FBSeletronica/Projeto-Natal-2023-Fabio/Projeto Base/Projeto-Natal-2023-Base/Documentação/christimas-ball-front.png

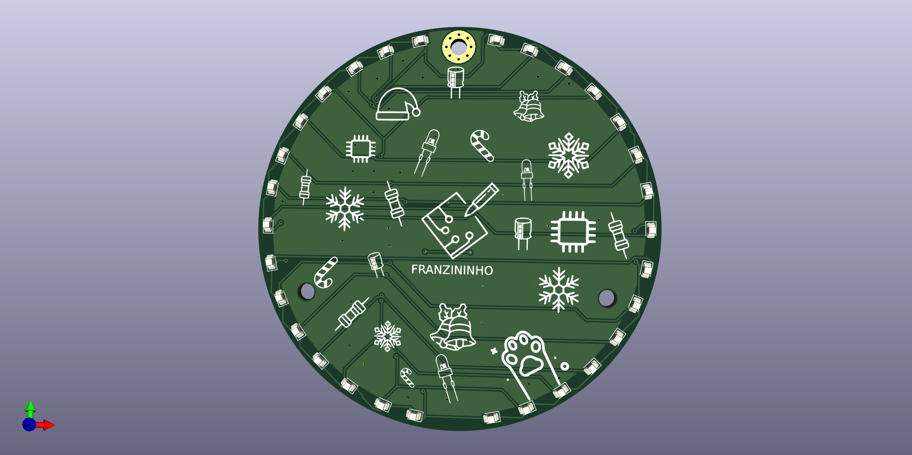
Projeto Base/Projeto-Natal-2023-Base/Documentação/christimas-ball-front.png
