FBSeletronica/Projeto-Natal-2023-Fabio/Projeto Base/Projeto-Natal-2023-Base/Documentação/custos.ods

descrição | valor
placa JLCPCB | 361,2
10 conector bateria | 50,61
5 buzzer | 60,81
10 bolas de acrĺico | 12
Demais componentes | 141,74
impostos placas | 111,33
impostos placas | 86,66
impostos componentes | 78,48
Total | 902,83
Valor por placa | 60,1886666666667
