FBSeletronica/Projeto-Natal-2023-Fabio/Projeto Base/Projeto-Natal-2023-Base/3D/EVQP7A01P.stp

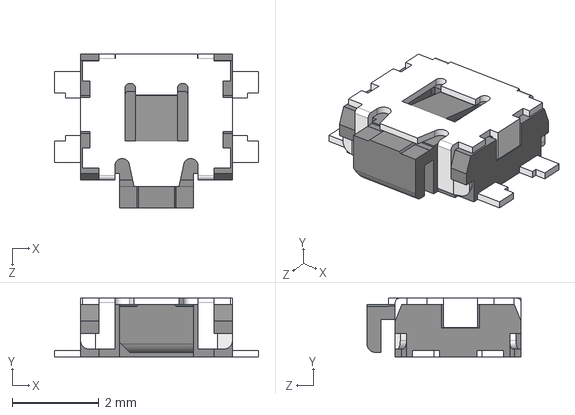
[picture p3: CAD file, 2023-11-22]
Projeto Base/Projeto-Natal-2023-Base/3D/EVQP7A01P.stp
4.70 x 1.35 x 3.55 mm
