FBSeletronica/Projeto-Natal-2023-Fabio/Projeto Base/Projeto-Natal-2023-Base/3D/BC-2001.stp

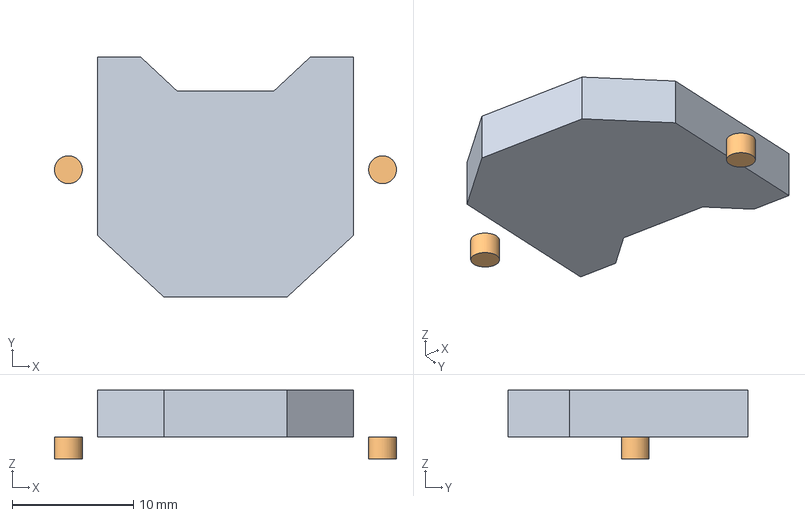
[picture p4: CAD file, 2023-11-20]
Projeto Base/Projeto-Natal-2023-Base/3D/BC-2001.stp
28.2 x 19.8 x 5.65 mm
Lugs x 2
