FBSeletronica/Projeto-Natal-2023-Fabio/Projeto Base/Projeto-Natal-2023-Base/3D/MLT-5030.stp

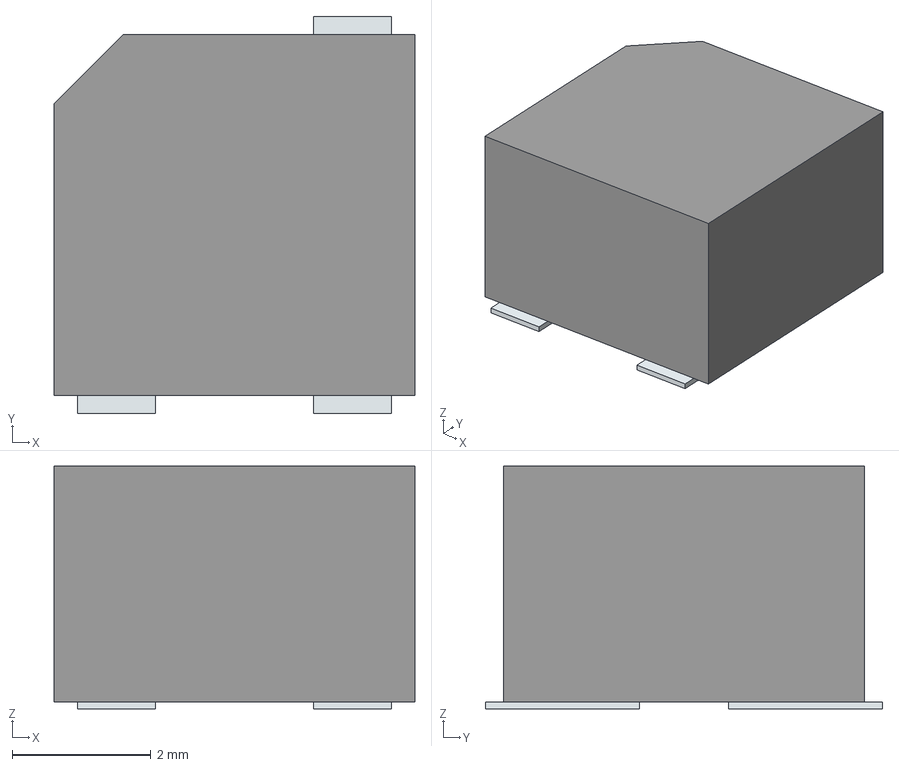
[picture p5: CAD file, 2023-11-20]
Projeto Base/Projeto-Natal-2023-Base/3D/MLT-5030.stp
5.20 x 5.72 x 3.50 mm
Pins
