FBSeletronica/Projeto-Natal-2023-Fabio/Projeto Base/Projeto-Natal-2023-Base/Documentação/dimensões.pdf

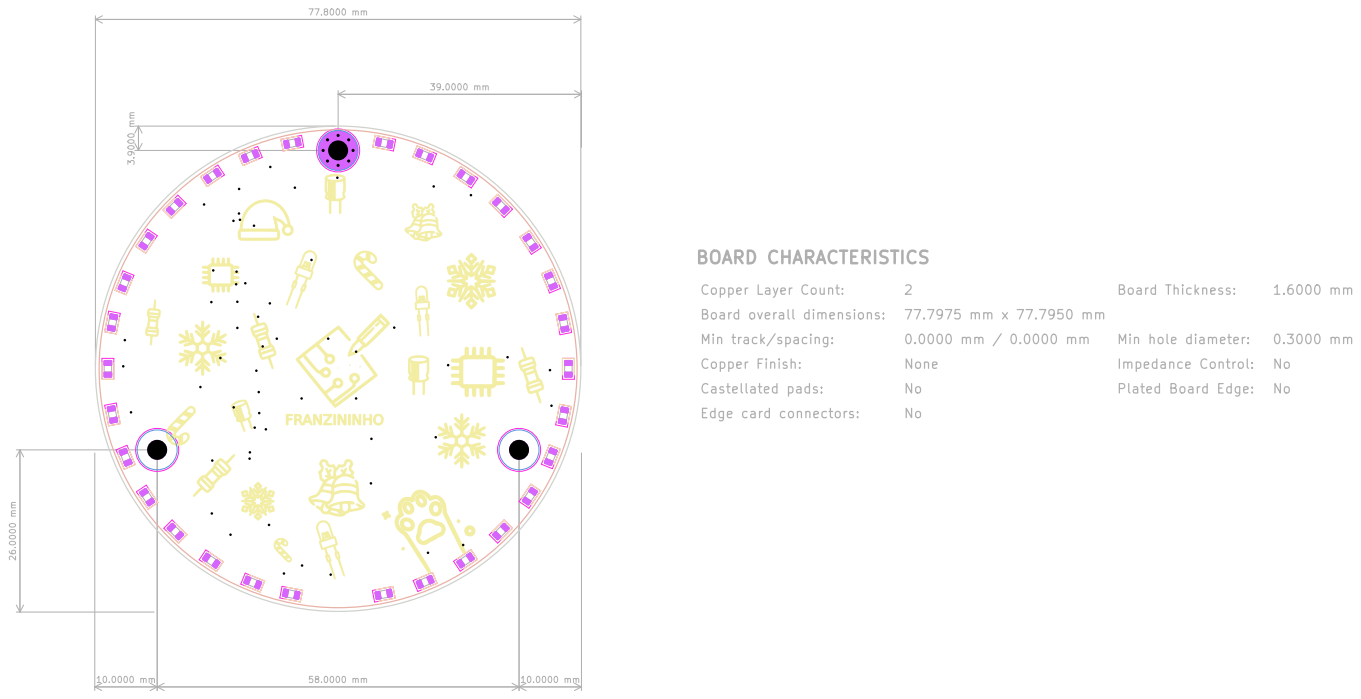
[picture p6: page 1]
