FBSeletronica/Projeto-Natal-2023-Fabio/Projeto Base/Projeto-Natal-2023-Base/Documentação/Christmas-ball.pdf

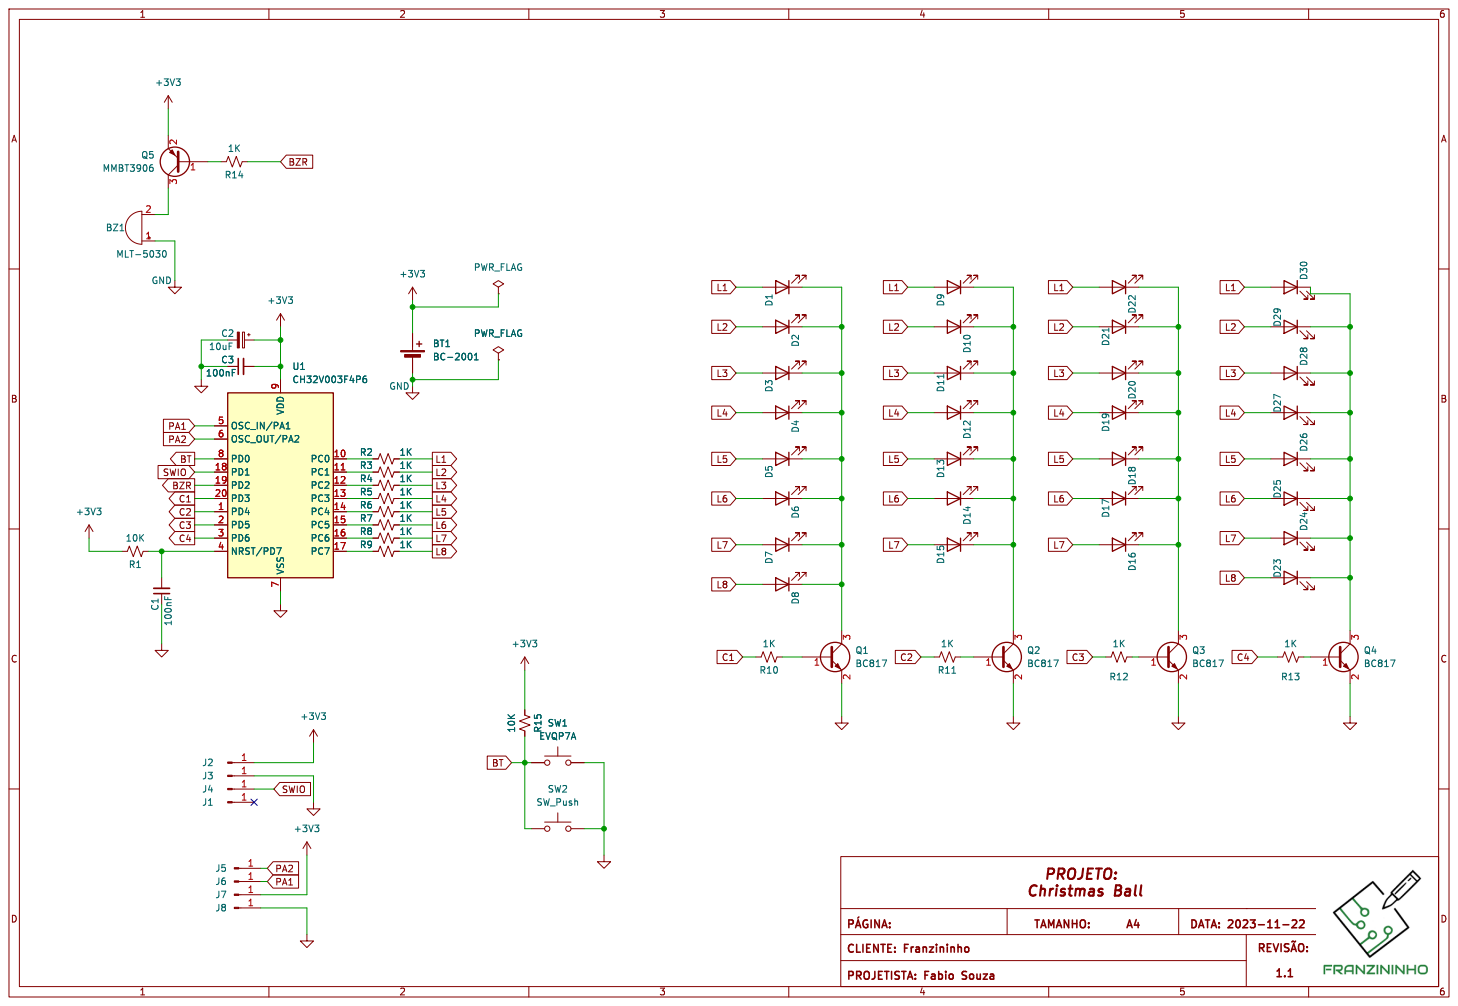
[picture p7: page 1]
