FBSeletronica/Projeto-Natal-2023-Fabio/Projeto Base/Projeto-Natal-2023-Base/Projeto-Natal-2023-Base.kicad_pcb

## KiCad design Projeto Base/Projeto-Natal-2023-Base/Projeto-Natal-2023-Base.kicad_pcb (2023-11-23)

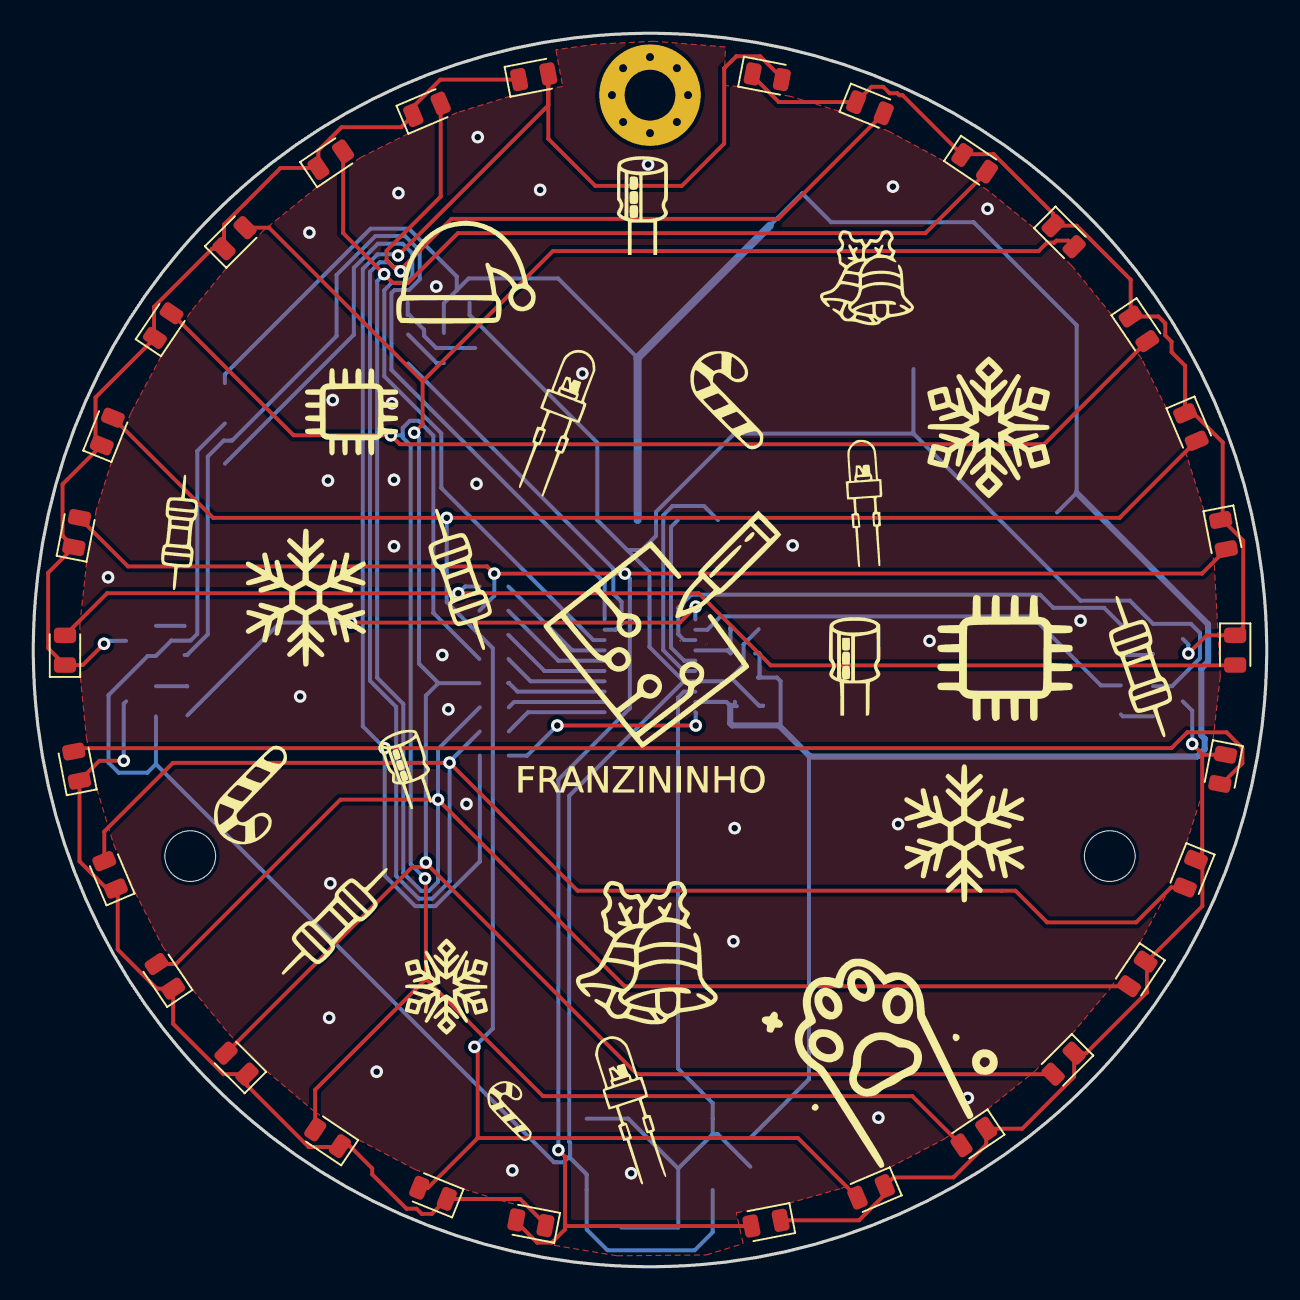
[picture p8: board Projeto-Natal-2023-Base.kicad_pcb from above]

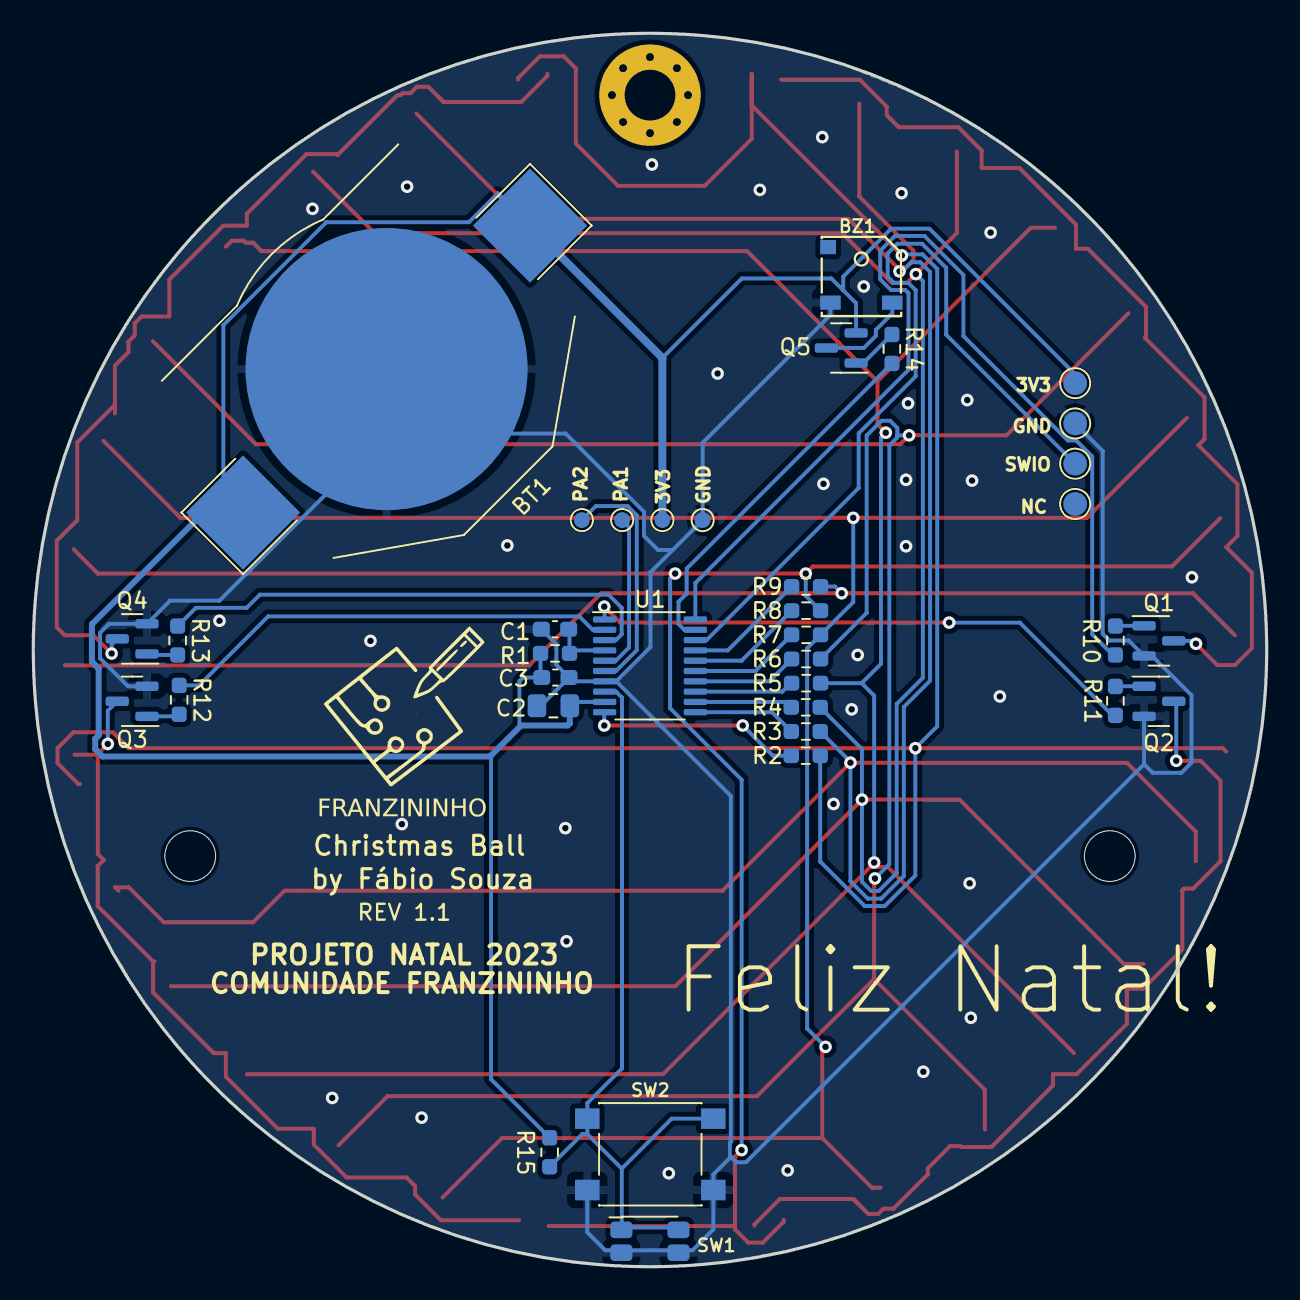
[picture p9: board Projeto-Natal-2023-Base.kicad_pcb from below]

Board: 2 copper layers, 77.8 x 77.8 mm, 68 parts (36 on the bottom side), 38 nets.

Parts:
BT1: BC-2001; BatteryHolder_Keystone_3002_1x2032
BZ1: MLT-5030; PassiveBuzzerSMD_JiangsuHuaneng_MLT-5030
C1, C3: 100nF; C_0603_1608Metric_Pad1.08x0.95mm_HandSolder
C2: 10uF; C_0805_2012Metric_Pad1.18x1.45mm_HandSolder
D1, D4, D7, D10, D13, D18, D21, D24, D27, D30: D-B080508B1-KS2; LED_0805_2012Metric
D2, D5, D8, D11, D14, D17, D20, D23, D26, D29: e17-21SURC/S530-A3/TR8; LED_0805_2012Metric
D3, D6, D9, D12, D15, D16, D19, D22, D25, D28: NCD0805G1; LED_0805_2012Metric
FURO1, FURO2: MountingHole_3.2mm_M3
J1, J2, J3, J4: Conn_01x01_Pin; TestPoint_Pad_D1.5mm
J5, J6, J7, J8: Conn_01x01_Pin; TestPoint_Pad_D1.0mm
Q1, Q2, Q3, Q4: BC817; SOT-23
Q5: MMBT3906; SOT-23
R1, R15: 10K; R_0603_1608Metric_Pad0.98x0.95mm_HandSolder
R2, R3, R4, R5, R6, R7, R8, R9, R10, R11, R12, R13, R14: 1K; R_0603_1608Metric_Pad0.98x0.95mm_HandSolder
SW1: EVQP7A; SW_SPST_EVQP7A
SW2: SW_Push; SW_Push_1P1T_NO_6x6mm_H9.5mm
U1: CH32V003F4P6; TSSOP-20_4.4x6.5mm_P0.65mm

Connections:
+3V3: BT1.1 (+), C2.1, C3.2, J2.1, J7.1, Q5.2 (E), R1.1, R15.2, U1.9 (VDD)
BT: R15.1, SW1.1, SW2.1, U1.8 (PD0)
BZR: R14.2, U1.19 (PD2)
C1: R10.1, U1.20 (PD3)
C2: R11.1, U1.1 (PD4)
C3: R12.1, U1.2 (PD5)
C4: R13.1, U1.3 (PD6)
GND: BT1.2 (-), BZ1.1 (-), C1.1, C2.2, C3.1, J3.1, J8.1, Q1.2 (E), Q2.2 (E), Q3.2 (E), Q4.2 (E), SW1.2, SW2.2, U1.7 (VSS)
L1: D1.2 (A), D9.2 (A), D22.2 (A), D30.2 (A), R2.2
L2: D2.2 (A), D10.2 (A), D21.2 (A), D29.2 (A), R3.2
L3: D3.2 (A), D11.2 (A), D20.2 (A), D28.2 (A), R4.2
L4: D4.2 (A), D12.2 (A), D19.2 (A), D27.2 (A), R5.2
L5: D5.2 (A), D13.2 (A), D18.2 (A), D26.2 (A), R6.2
L6: D6.2 (A), D14.2 (A), D17.2 (A), D25.2 (A), R7.2
L7: D7.2 (A), D15.2 (A), D16.2 (A), D24.2 (A), R8.2
L8: D8.2 (A), D23.2 (A), R9.2
unnamed: BZ1.2 (+), Q5.3 (C)
unnamed: D1.1 (K), D2.1 (K), D3.1 (K), D4.1 (K), D5.1 (K), D6.1 (K), D7.1 (K), D8.1 (K), Q1.3 (C)
unnamed: D9.1 (K), D10.1 (K), D11.1 (K), D12.1 (K), D13.1 (K), D14.1 (K), D15.1 (K), Q2.3 (C)
unnamed: D16.1 (K), D17.1 (K), D18.1 (K), D19.1 (K), D20.1 (K), D21.1 (K), D22.1 (K), Q3.3 (C)
unnamed: D23.1 (K), D24.1 (K), D25.1 (K), D26.1 (K), D27.1 (K), D28.1 (K), D29.1 (K), D30.1 (K), Q4.3 (C)
unnamed: Q1.1 (B), R10.2
unnamed: Q2.1 (B), R11.2
unnamed: Q3.1 (B), R12.2
unnamed: Q4.1 (B), R13.2
unnamed: Q5.1 (B), R14.1
unnamed: C1.2, R1.2, U1.4 (NRST/PD7)
unnamed: R2.1, U1.10 (PC0)
unnamed: R3.1, U1.11 (PC1)
unnamed: R4.1, U1.12 (PC2)
unnamed: R5.1, U1.13 (PC3)
unnamed: R6.1, U1.14 (PC4)
unnamed: R7.1, U1.15 (PC5)
unnamed: R8.1, U1.16 (PC6)
unnamed: R9.1, U1.17 (PC7)
PA1: J6.1, U1.5 (OSC_IN/PA1)
PA2: J5.1, U1.6 (OSC_OUT/PA2)
SWIO: J4.1, U1.18 (PD1)
