FBSeletronica/Projeto-Natal-2023-Fabio/(commit log)

2023-11-15 Draft 1
    [Projeto-Natal-2023-Base.kicad_pcb, Projeto-Natal-2023-Base.kicad_sch]
2023-11-16 posicionando os componentes
    [Projeto-Natal-2023-Base.kicad_pcb, Projeto-Natal-2023-Base.kicad_sch]
2023-11-20 update 3D
    [BC-2001.stp, MLT-5030.stp, Projeto-Natal-2023-Base.kicad_pcb]
2023-11-20 Versão para revisão
    [Projeto-Natal-2023-Base.kicad_pcb, Projeto-Natal-2023-Base.kicad_sch]
2023-11-20 update silk
    [Projeto-Natal-2023-Base.kicad_pcb]
2023-11-21 Adicionando pinos extras e resistor de pullup para o BT
    [Projeto-Natal-2023-Base.kicad_pcb, Projeto-Natal-2023-Base.kicad_sch]
2023-11-21 Fim v1.0.0
    [Projeto-Natal-2023-Base.kicad_pcb]
2023-11-22 V1.1.0
    Placa com 78,8 mm de diametro
    [Projeto-Natal-2023-Base.kicad_sch, bom.csv, designators.csv, freerouting.dsn, positions.csv]
2023-11-22 update files
    [Projeto-Natal-2023-Base.kicad_pcb]
2023-11-22 Versao fabricada
    [EVQP7A01P.stp, Projeto-Natal-2023-Base.kicad_pcb, bom.csv, designators.csv, positions.csv]
2023-11-23 adicionando + info para fabricação
    BOM, iBOM, custos atẽ o momento, dimensões
    [Projeto-Natal-2023-Base.csv, Projeto-Natal-2023-Base.kicad_pcb, Projeto-Natal-2023-Base.kicad_sch, bom.csv, custos.ods]
2023-11-23 adicionando imagem e planilha para posicionamento dos leds
    [leds.ods]
2023-11-23 Organizando arquivos em pastas
    [Projeto-Natal-2023-Base.csv, custos.ods, leds.ods]
2023-11-26 atualizando custos
    [custos.ods]
